gxurma/bondheadsteering/README.md

# bondheadsteering
App to steer a heated bondhead
