gxurma/bondheadsteering/CAD/BondheadSteering/stecker.stl

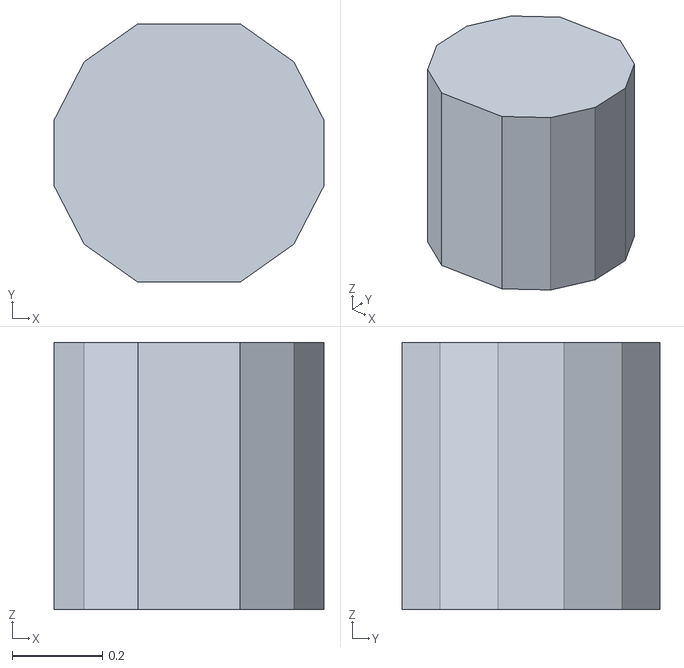
[picture p3: CAD file, 2025-11-16]
CAD/BondheadSteering/stecker.stl
0.597 x 0.571 x 0.591
