gxurma/bondheadsteering/(list of files, cad)

Other CAD files:
CAD/BondheadSteering/Schalter.psm
CAD/BondheadSteering/Sheet Metal2.psm
CAD/BondheadSteering/stecker.psm
