gxurma/bondheadsteering/CAD/BondheadSteering/gbr/BondheadSteering-B_Cu.pdf

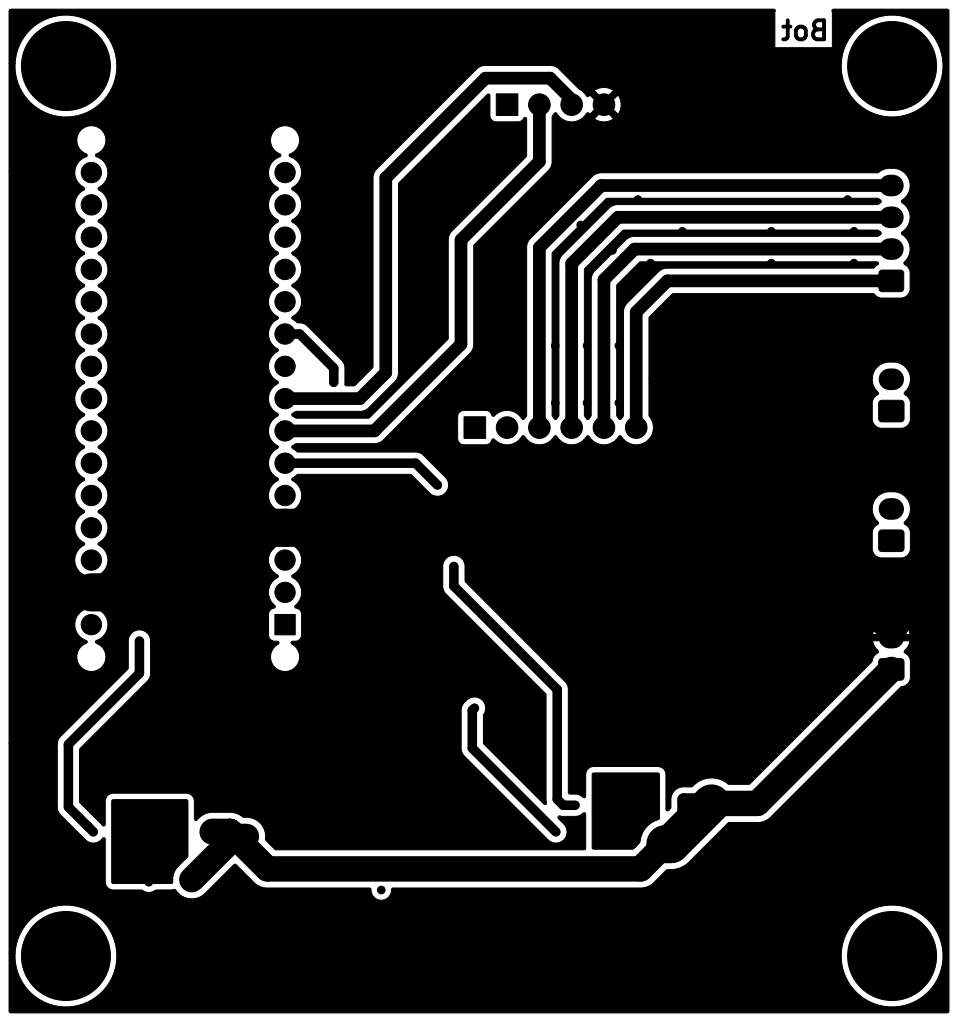
[picture p4: page 1]
