gxurma/bondheadsteering/CAD/BondheadSteering/gbr/BondheadSteering-B_Mask.pdf

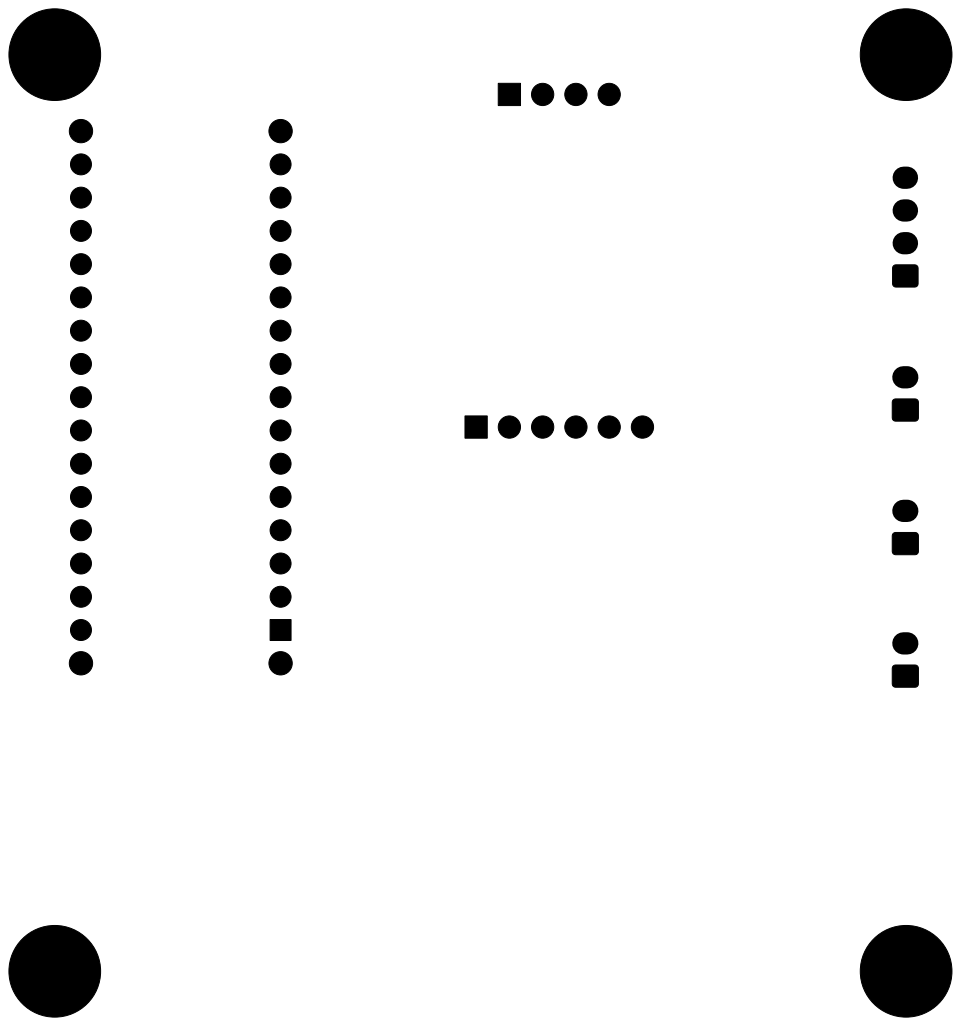
[picture p5: page 1]
