gxurma/bondheadsteering/CAD/BondheadSteering/gbr/BondheadSteering-F_Cu.pdf

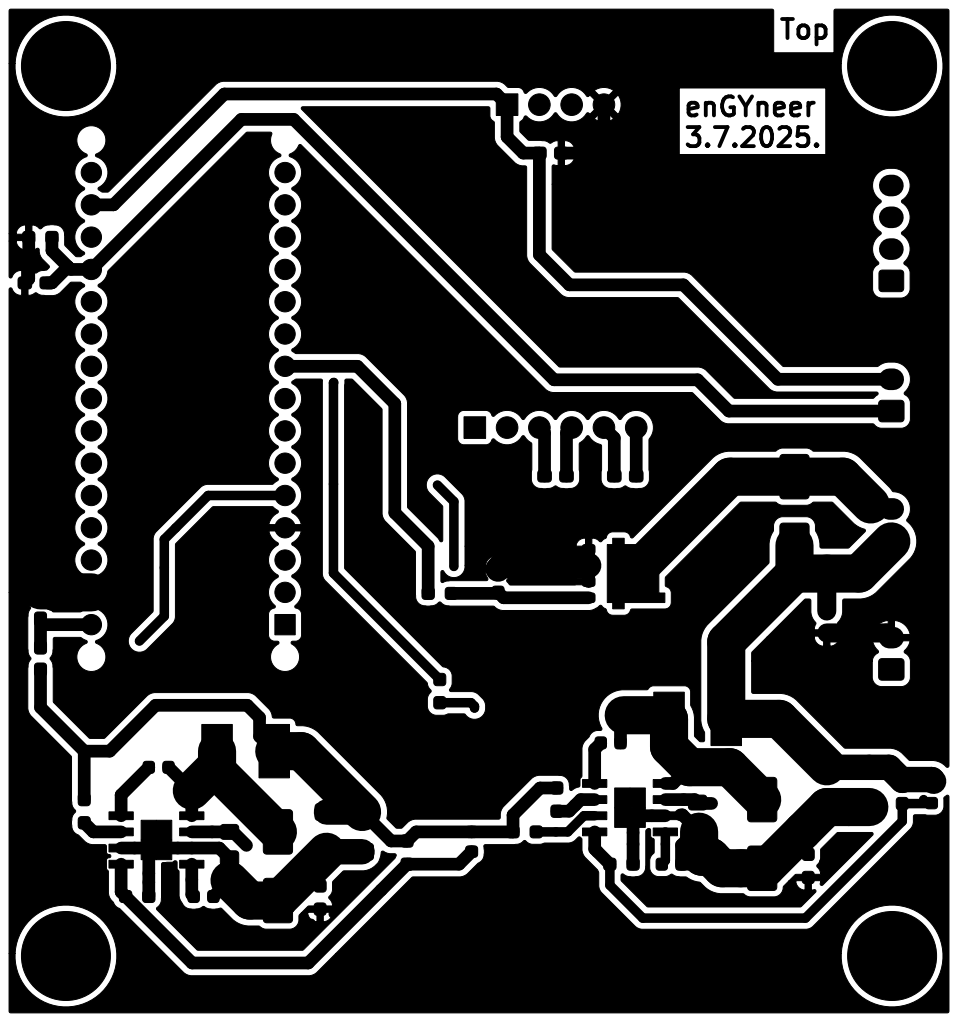
[picture p6: page 1]
