gxurma/bondheadsteering/CAD/BondheadSteering/gbr/BondheadSteering-F_Mask.pdf

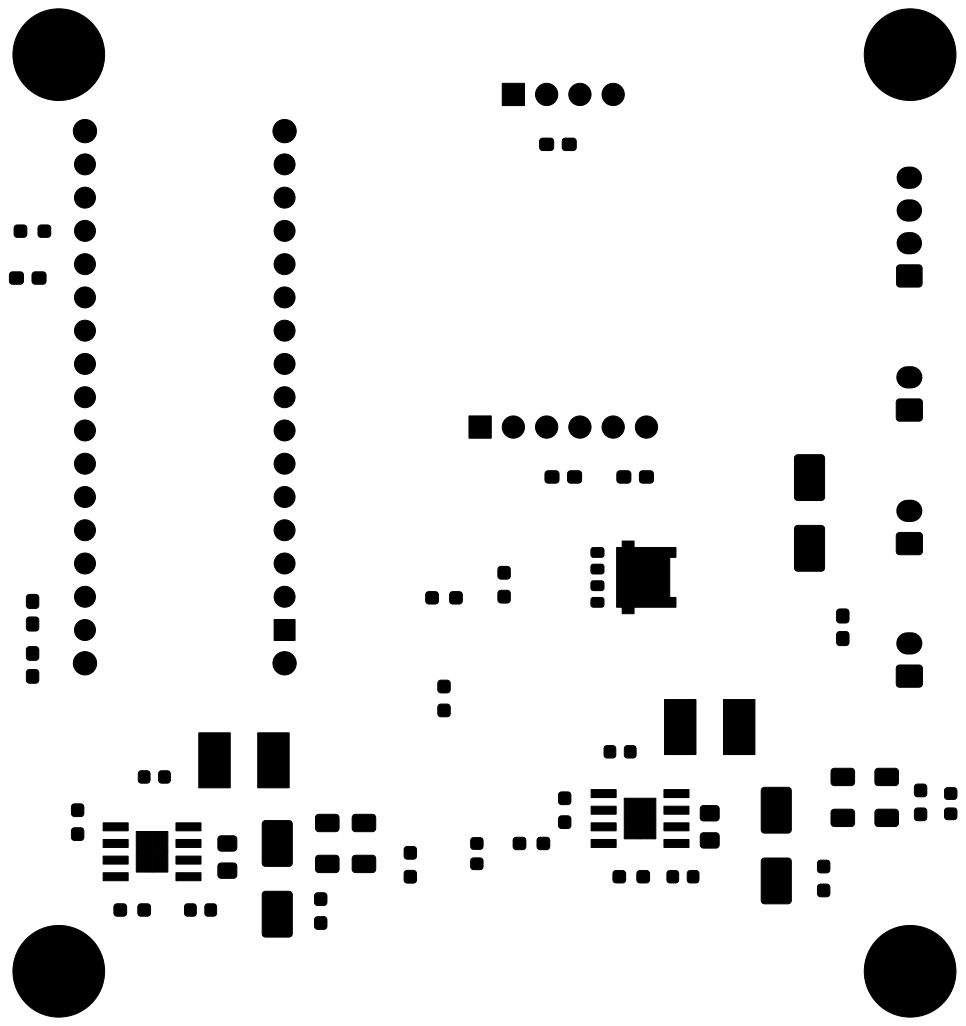
[picture p7: page 1]
