gxurma/bondheadsteering/CAD/BondheadSteering/gbr/BondheadSteering-F_Paste.pdf

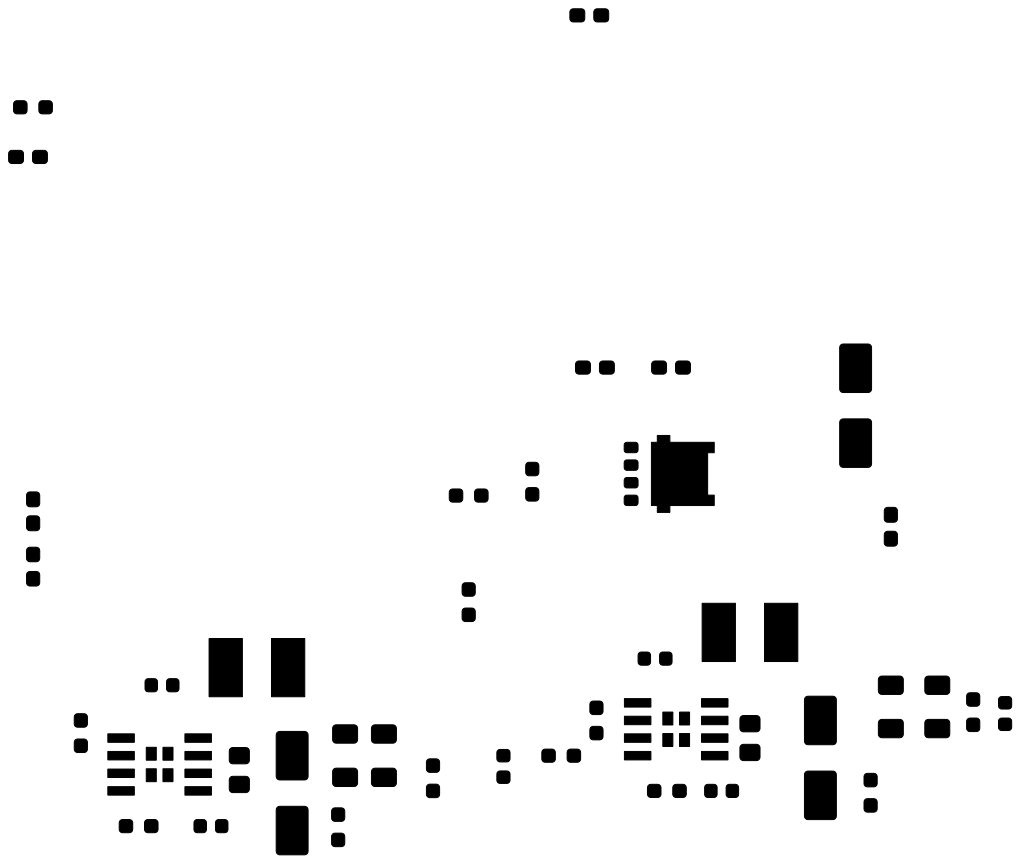
[picture p8: page 1]
