gxurma/bondheadsteering/CAD/BondheadSteering/gbr/BondheadSteering-F_Silkscreen.pdf

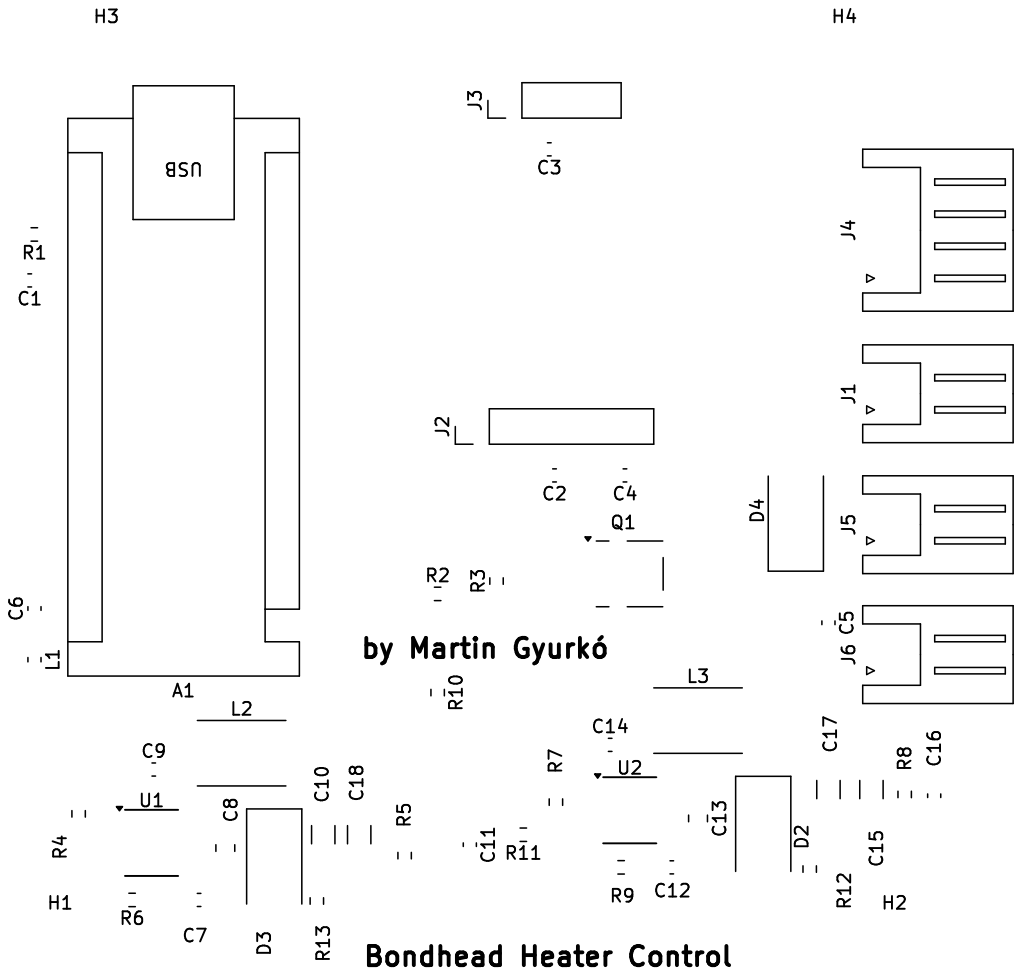
[picture p9: page 1]
