gxurma/bondheadsteering/CAD/BondheadSteering/gbr/BondheadSteering-User_Drawings.pdf

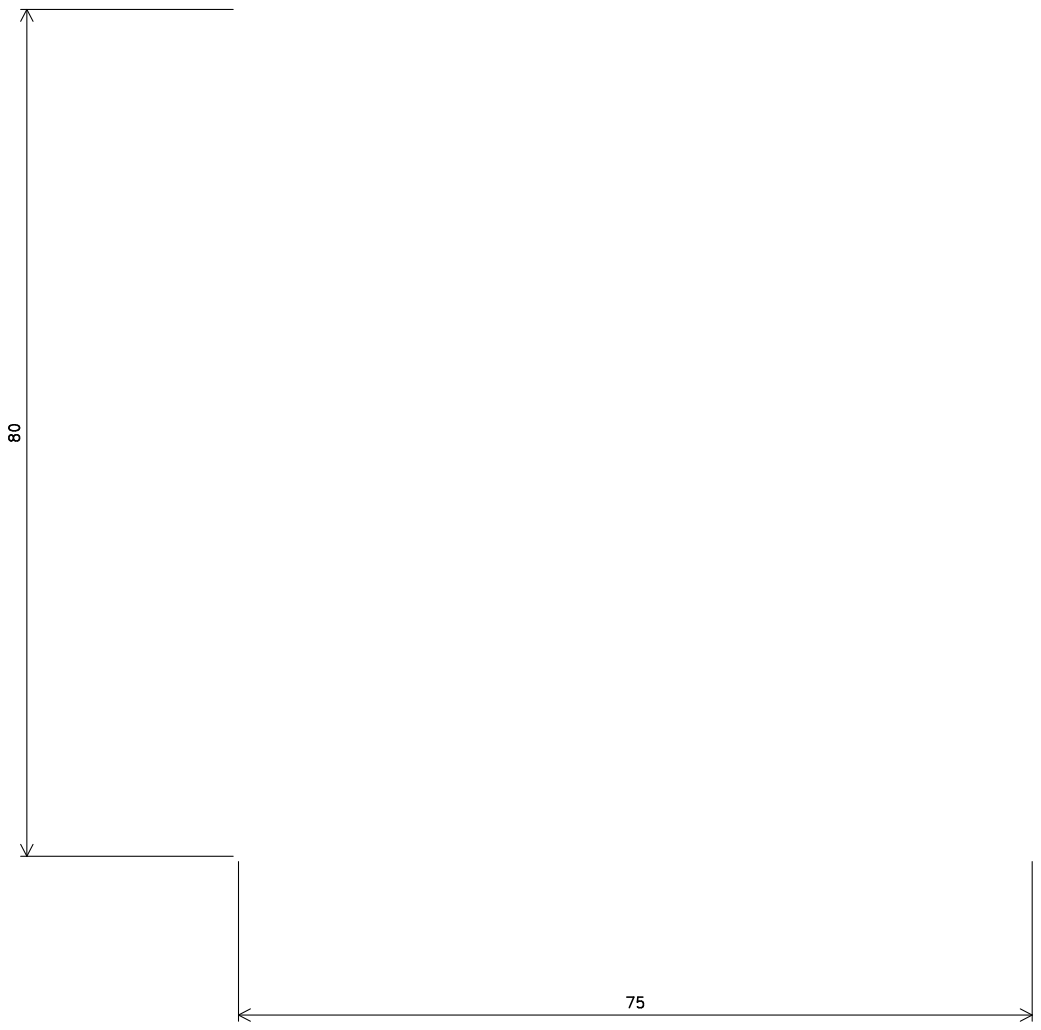
[picture p10: page 1]
