gxurma/bondheadsteering/CAD/BondheadSteering/BondheadSteering.kicad_pcb

## KiCad design CAD/BondheadSteering/BondheadSteering.kicad_pcb (2025-11-16)

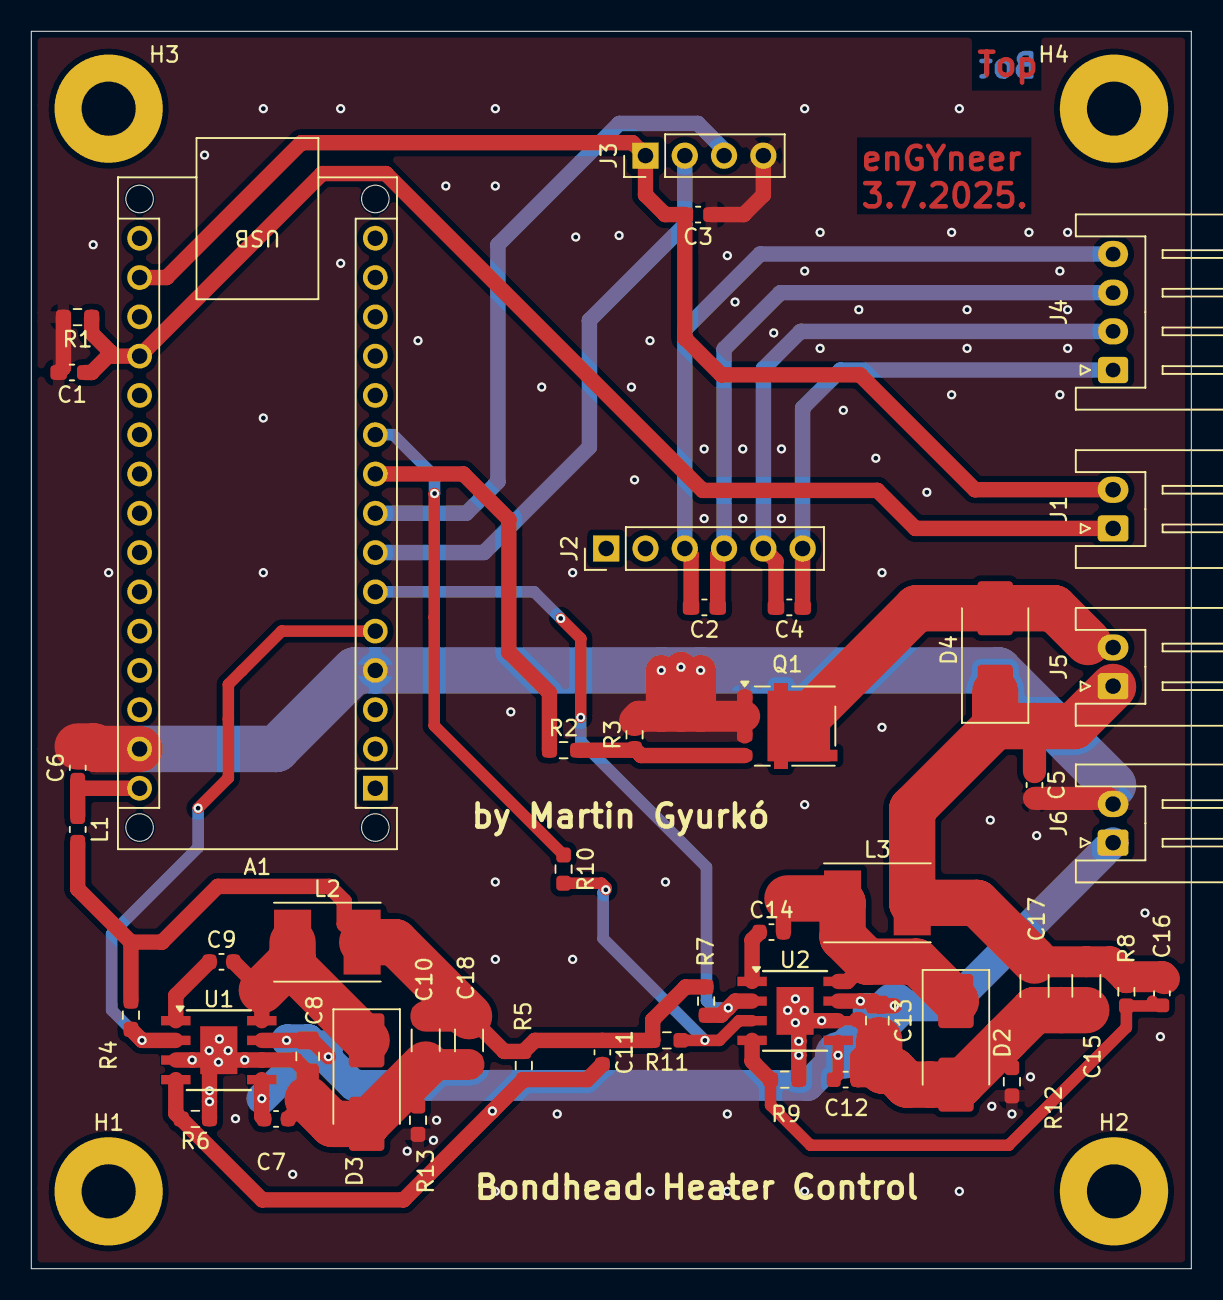
[picture p11: board BondheadSteering.kicad_pcb from above]

Board: 2 copper layers, 75.0 x 80.0 mm, 51 parts (0 on the bottom side), 28 nets.

Parts:
A1: Arduino_Nano_RP2040_Connect; Arduino_Nano_WithMountingHoles
C1, C2, C3, C4, C5, C6: 1u; C_0603_1608Metric_Pad1.08x0.95mm_HandSolder
C7, C9, C12, C14: 100n; C_0603_1608Metric
C8, C13: 10u; C_0805_2012Metric_Pad1.18x1.45mm_HandSolder
C10, C15, C17, C18: 47u; C_1206_3216Metric_Pad1.33x1.80mm_HandSolder
C11, C16: 150p; C_0603_1608Metric
D2, D3, D4: STPS3L60U; D_SMB_Handsoldering
H1, H2, H3, H4: MountingHole; MountingHole_3.5mm_Pad
J1, J5, J6: Conn_01x02_Pin; JST_XH_S2B-XH-A_1x02_P2.50mm_Horizontal
J2: Conn_01x06_Socket; PinHeader_1x06_P2.54mm_Vertical
J3: Conn_01x04_Socket; PinHeader_1x04_P2.54mm_Vertical
J4: Conn_01x04_Pin; JST_XH_S4B-XH-A_1x04_P2.50mm_Horizontal
L1: 1uH; L_0603_1608Metric_Pad1.05x0.95mm_HandSolder
L2, L3: 10u; L_Taiyo-Yuden_NR-50xx_HandSoldering
Q1: AP90N02NF NMOS; ONSemi_SO-8FL_488AA
R1: 1961R; R_0603_1608Metric_Pad0.98x0.95mm_HandSolder
R2, R10: 100R; R_0603_1608Metric_Pad0.98x0.95mm_HandSolder
R3, R5, R8, R11: 10k; R_0603_1608Metric_Pad0.98x0.95mm_HandSolder
R4, R7: 47k; R_0603_1608Metric_Pad0.98x0.95mm_HandSolder
R6: 3160; R_0603_1608Metric_Pad0.98x0.95mm_HandSolder
R9: 1100; R_0603_1608Metric_Pad0.98x0.95mm_HandSolder
R12, R13: 0R; R_0603_1608Metric_Pad0.98x0.95mm_HandSolder
U1, U2: ST1S14PHR; TI_SO-PowerPAD-8

Connections:
+5V: C10.1, C11.1, C18.1, L1.2, L2.2, R4.1, R5.2, R7.1, R11.2
+12V: C5.1, C15.1, C16.1, C17.1, D4.1 (K), J5.1, L3.2, R8.2
+24V: C7.1, C8.1, C12.1, C13.1, J6.1, U1.5 (EN2), U1.7 (VIN), U2.5 (EN2), U2.7 (VIN)
/3V3: A1.17 (3V3), C3.2, J1.2, J3.1
/Boot5: C9.1, U1.1 (BOOT)
/Boot12: C14.1, U2.1 (BOOT)
/FB5: C11.2, R5.1, R6.2, U1.4 (FB)
/FB12: C16.2, R8.1, R9.2, U2.4 (FB)
/Switch5: C9.2, D3.1 (K), L2.1, U1.8 (SW)
/Switch12: C14.2, D2.1 (K), L3.1, U2.8 (SW)
/TempIn: A1.19 (A0), C1.1, J1.1, R1.1
GND1: C12.2, C13.2, C15.2, C17.2, D2.2 (A), R9.1, R12.2, U2.6 (GND), U2.9 (PADGND)
GND2: C7.2, C8.2, C10.2, C18.2, D3.2 (A), R6.1, R13.2, U1.3 (~EN1), U1.6 (GND), U1.9 (PADGND)
GNDD: A1.4 (GND), A1.29 (GND), C1.2, C3.1, C5.2, C6.2, J3.4, J6.2, Q1.1 (S), Q1.2 (S), Q1.3 (S), R1.2, R3.2, R12.1, R13.1
unnamed: A1.7 (D4), J3.2
unnamed: A1.8 (D5), J3.3
unnamed: A1.9 (D6), R2.1
unnamed: A1.10 (D7), R10.1
unnamed: A1.30 (VIN), C6.1, L1.1
unnamed: D4.2 (A), J5.2, Q1.5 (D)
unnamed: C2.2, J2.3, J4.4
unnamed: C2.1, J2.4, J4.3
unnamed: C4.2, J2.5, J4.2
unnamed: C4.1, J2.6, J4.1
unnamed: Q1.4 (G), R2.2, R3.1
unnamed: R10.2, R11.1, U2.3 (~EN1)
PGood5: A1.5 (D2), R4.2, U1.2 (PG)
PGood12: A1.6 (D3), R7.2, U2.2 (PG)
