gxurma/bondheadsteering/(commit log)

2025-05-31 Arduino sketch für den Heizer
2025-06-03 had to change heater indication so that it was working with the arduino plotter
2025-06-29 added CAD for the control unit
    [BondheadSteering.kicad_pcb, BondheadSteering.kicad_sch]
2025-07-24 now with serial parsing and force calibration
2025-11-14 new force calibration value for the flat cell
2025-11-16 Some CAD files
    [BondheadSteering-B_Cu.gbr, BondheadSteering-B_Mask.gbr, BondheadSteering-B_Paste.gbr, BondheadSteering-B_Silkscreen.gbr, BondheadSteering-Edge_Cuts.gbr, BondheadSteering-F_Cu.gbr, BondheadSteering-F_Mask.gbr, BondheadSteering-F_Paste.gbr]
