gxurma/bondheadsteering/(notices)

Notices in the files:
CAD/BondheadSteering/BondheadSteering.kicad_sch:
(c) 2025
